dronecz/maker_badge/HW/rev_C/gerber-bom-pnp/MF_badge_2021_rev_C_BOM.xls

Designator | Qty | Value | Device | Package | LCSC part no
CR2032 | 1 |  | BATTERYCR2032_BAT-HLD-001 | CR2032_SMT_BAT-HLD-001 | C964831
R3 | 1 | 0 | R-EU_R0805 | R0805 | C17477
R2 | 1 | 0.47 | R-EU_R0805 | R0805 | C25040
R5 | 1 | 100k | R-EU_R0805 | R0805 | C149504
C8, C18 | 2 | 100n | C-EUC0805 | C0805 | C1711
R1, R7, R8, R10, R11, R12, R30, R31 | 8 | 10k | R-EU_R0805 | R0805 | C17414
C13, C14, C16, C19, C20 | 5 | 10u | C-EUC0805 | C0805 | C1713
R9 | 1 | 1M | R-EU_R0805 | R0805 | C17514
R6 | 1 | 1k | R-EU_R0805 | R0805 | C17513
C1, C2, C3, C4, C5, C6, C9, C11, C15, C17, C22 | 11 | 1u | C-EUC0805 | C0805 | C28323
R17, R18 | 2 | 22 | R-EU_R0805 | R0805 | C107702
R22, R23 | 2 | 4k7 | R-EU_R0805 | R0805 | C2907264
C10, C12 | 2 | 4u7 | C-EUC0805 | C0805 | C98192
R15, R16 | 2 | 5k1 | R-EU_R0805 | R0805 | C27834
L1 | 1 | 68uH | L-EUL4532P | L4532P | C394131
U2 | 1 | AP2112K-3.3 | VREG_SOT23-5 | SOT23-5 | C51118
BOOT, RST | 2 | KMR221GLFS | KMR221GLFS | KMR221GLFS | C72443
Q2, Q3 | 2 | DMG3415U-7 | MOSFET-P | SOT23-R | C96616
U1 | 1 | ESP32-S2-WROOM | ESP32-S2-WROOM | XCVR_ESP32-S2-WROOM | C967025
J1 | 1 | TYPE-C-31-M-12 | TYPE-C-31-M-12 | TYPE-C-31-M-12 | C165948
U$8 | 1 | JST_PH2 | JST_PH2 | JSTPH2 | C295747
D1, D2, D3, D5 | 4 | MBR0520LT | MBR0520LT | SOD123 | C165467
IC1 | 1 | MCP73831 | MCP73831 | SOT95P290X120-5 | C14879
C7 | 1 | OMIT | C-EUC0805 | C0805
R4 | 1 | OMIT | R-EU_R0805 | R0805
D4 | 1 | ORANGE | LED0805_NOOUTLINE | CHIPLED_0805_NOOUTLINE | C72037
Q1 | 1 | SI1308EDL-T1-GE3 | SI1308EDL-T1-GE3 | SOT-323 | C469327
LED2, LED3, LED4, LED5 | 4 | WS2812B5050 | WS2812B5050 | WS2812B | C2843785
