dronecz/maker_badge/HW/rev_D/MF_badge_2021_rev_D.brd

## EAGLE design HW/rev_D/MF_badge_2021_rev_D.brd (2023-02-20)

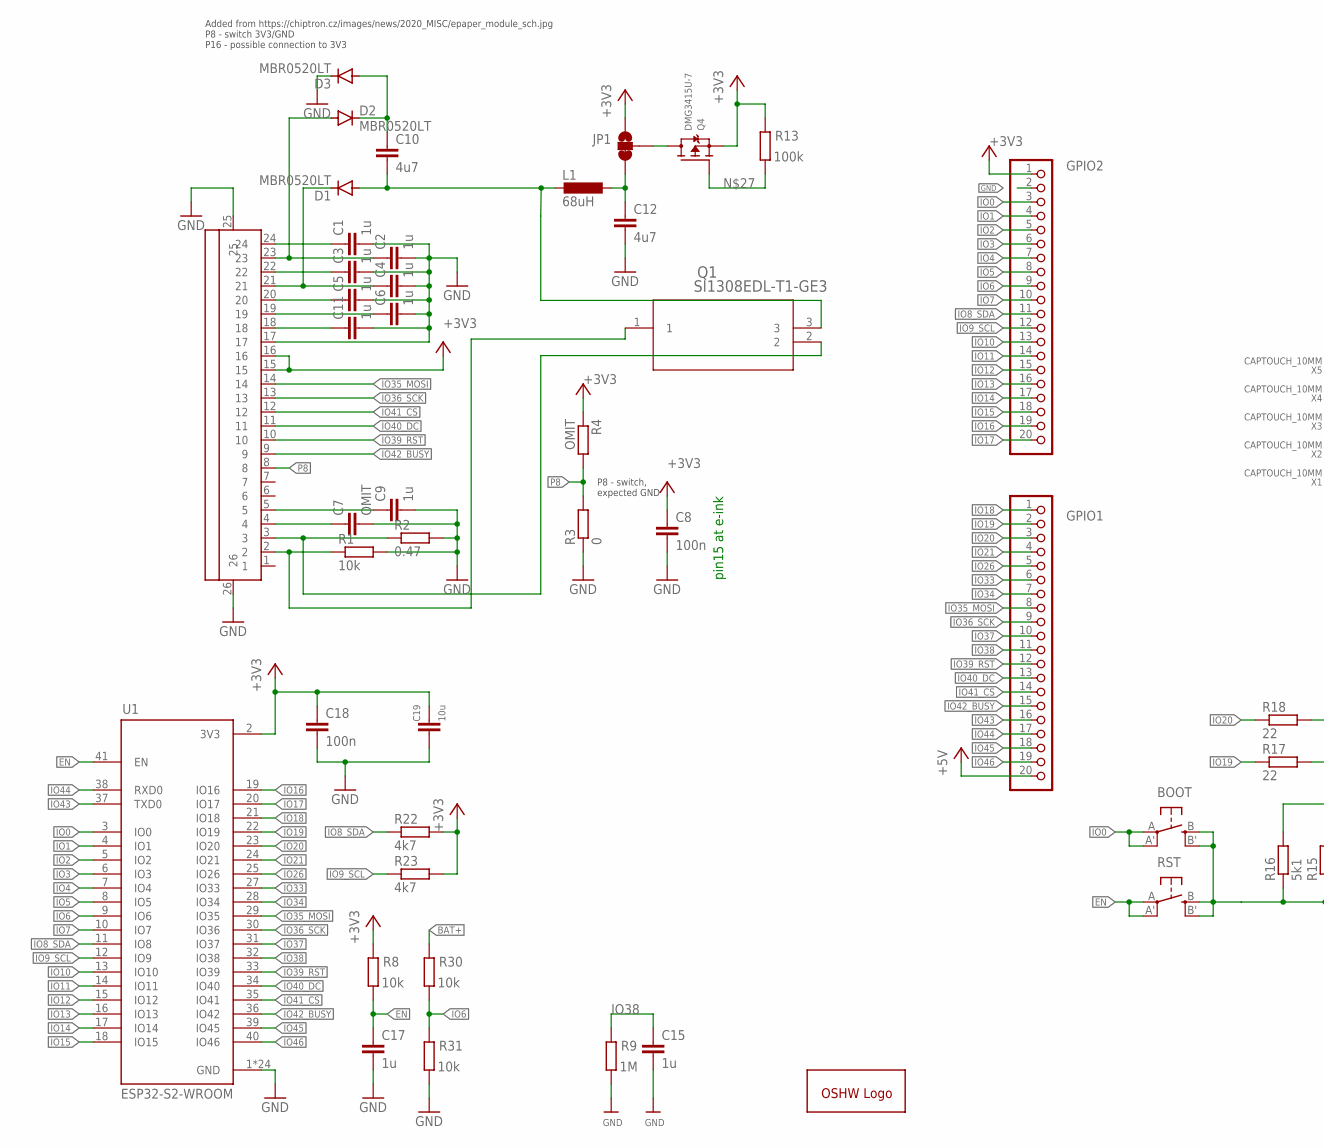
[picture p1: schematic MF_badge_2021_rev_D.sch, part in row 1, column 1]

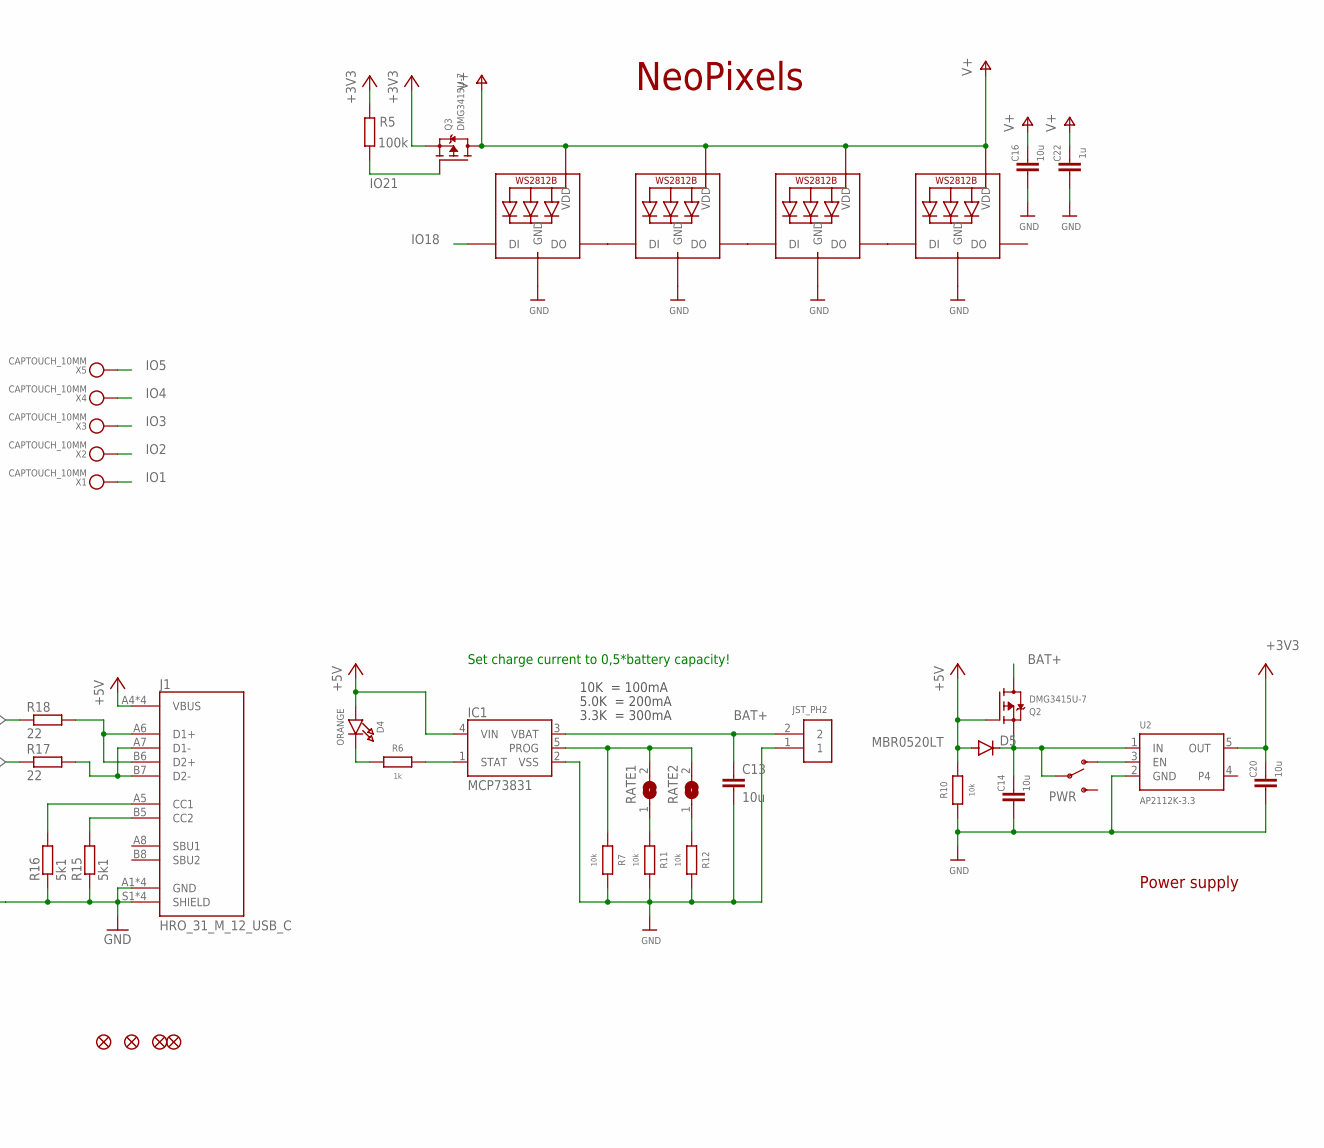
[picture p2: schematic MF_badge_2021_rev_D.sch, part in row 1, column 2]

Parts:
BOOT: BUTTON_KMR2_4.6X2.8
C1, C2, C3, C4, C5, C6, C9, C11, C15, C17, C22: 1u; C0805
C7: OMIT; C0805
C8, C18: 100n; C0805
C10, C12: 4u7; C0805
C13, C14, C16, C19, C20: 10u; C0805
D1, D2, D3, D5: MBR0520LT; SOD123
D4: ORANGE; CHIPLED_0805_NOOUTLINE
FID1, FID2, FID3, FID4: FIDUCIAL_1MM
GOLD_ORB_SM1: OSHWLOGO_; OSHW_5MM_LOGO
GPIO1, GPIO2: PINHD-1X20; 1X20
IC1: MCP73831; SOT95P290X120-5
J1: HRO_31_M_12_USB_C
JP1: JUMPER-SMT_3_1-NC_TRACE_NO-SILK; SMT-JUMPER_3_1-NC_TRACE_NO-SILK
L1: 68uH; L4532P
LED2, LED3, LED4, LED5: WS2812B5050; WS2812B
PWR: SWITCH-SPDT-SMD-RIGHT-ANGLE; SWITCH_SPST_SMD_A
Q1: SI1308EDL-T1-GE3; MOSFET_8EDL-T1-GE3_VIS
Q2, Q3, Q4: DMG3415U-7; SOT23-R
R1, R7, R8, R10, R11, R12, R30, R31: 10k; R0805
R2: 0.47; R0805
R3: 0; R0805
R4: OMIT; R0805
R5, R13: 100k; R0805
R6: 1k; R0805
R9: 1M; R0805
R15, R16: 5k1; R0805
R17, R18: 22; R0805
R22, R23: 4k7; R0805
RATE1, RATE2: SOLDERJUMPER; SOLDERJUMPER_ARROW_NOPASTE
RST: BUTTON_KMR2_4.6X2.8
U1: ESP32-S2-WROOM; XCVR_ESP32-S2-WROOM
U2: AP2112K-3.3; SOT23-5
U$1: 2.13_EINK
U$8: JST_PH2; JSTPH2
X1, X2, X3, X4, X5: CAPTOUCH_10MM; CAPTOUCH_6X9MM

Connections:
+3V3: C8.1, C18.1, C19.1, C20.1, GPIO2.1, JP1.1, Q3.2 (S), Q4.2 (S), R4.1, R5.2, R8.2, R13.2, R22.2, R23.2, U1.2 (3V3), U2.5 (OUT), U$1.15, U$1.16
+5V: D4.A, D5.A, GPIO1.20, IC1.4 (VIN), J1.A4 (VBUS), J1.A9 (VBUS), J1.B4 (VBUS), J1.B9 (VBUS), Q2.1 (G), R10.2
BAT+: C13.1, IC1.3 (VBAT), Q2.3 (D), R30.2, U$8.2
D+_CON: J1.A6 (D1+), J1.B6 (D2+), R18.2
D-_CON: J1.A7 (D1-), J1.B7 (D2-), R17.2
EN: C17.1, R8.1, RST.A, RST.A' (P1), U1.41 (EN)
GND: BOOT.B (S), BOOT.B' (S1), C1.2, C2.2, C3.2, C4.2, C5.2, C6.2, C7.2, C8.2, C9.2, C11.2, C12.2, C13.2, C14.2, C15.2, C16.2, C17.2, C18.2, C19.2, C20.2, C22.2, D3.C, GPIO2.2, IC1.2 (VSS), J1.A1 (GND), J1.A12 (GND), J1.B1 (GND), J1.B12 (GND), J1.S1 (SHIELD), J1.S2 (SHIELD), J1.S3 (SHIELD), J1.S4 (SHIELD), LED2.3-GND (GND), LED3.3-GND (GND), LED4.3-GND (GND), LED5.3-GND (GND), R1.2, R2.2, R3.1, R7.2, R9.1, R10.1, R11.2, R12.2, R15.1, R16.1, R31.1, RST.B (S), RST.B' (S1), U1.1 (GND), U1.26 (GND), U1.42 (GND), U1.43.1 (GND), U1.43.2 (GND), U1.43.3 (GND), U1.43.4 (GND), U1.43.5 (GND), U1.43.6 (GND), U1.43.7 (GND), U1.43.8 (GND), U1.43.9 (GND), U1.43.10 (GND), U1.43.11 (GND), U1.43.12 (GND), U1.43.13 (GND), U1.43.14 (GND), U1.43.15 (GND), U1.43.16 (GND), U1.43.17 (GND), U1.43.18 (GND), U1.43.19 (GND), U1.43.20 (GND), U1.43.21 (GND), U2.2 (GND), U$1.17, U$1.25, U$1.26, U$8.1
IO0: BOOT.A, BOOT.A' (P1), GPIO2.3, U1.3 (IO0)
IO1: GPIO2.4, U1.4 (IO1), X1.P$1
IO2: GPIO2.5, U1.5 (IO2), X2.P$1
IO3: GPIO2.6, U1.6 (IO3), X3.P$1
IO4: GPIO2.7, U1.7 (IO4), X4.P$1
IO5: GPIO2.8, U1.8 (IO5), X5.P$1
IO6: GPIO2.9, R30.1, R31.2, U1.9 (IO6)
IO7: GPIO2.10, U1.10 (IO7)
IO8_SDA: GPIO2.11, R22.1, U1.11 (IO8)
IO9_SCL: GPIO2.12, R23.1, U1.12 (IO9)
IO10: GPIO2.13, U1.13 (IO10)
IO11: GPIO2.14, U1.14 (IO11)
IO12: GPIO2.15, U1.15 (IO12)
IO13: GPIO2.16, U1.16 (IO13)
IO14: GPIO2.17, U1.17 (IO14)
IO15: GPIO2.18, U1.18 (IO15)
IO16: GPIO2.19, U1.19 (IO16)
IO17: GPIO2.20, U1.20 (IO17)
IO18: GPIO1.1, LED2.4-DIN (DI), U1.21 (IO18)
IO19: GPIO1.2, R17.1, U1.22 (IO19)
IO20: GPIO1.3, R18.1, U1.23 (IO20)
IO21: GPIO1.4, Q3.1 (G), R5.1, U1.24 (IO21)
IO26: GPIO1.5, U1.25 (IO26)
IO33: GPIO1.6, U1.27 (IO33)
IO34: GPIO1.7, U1.28 (IO34)
IO35_MOSI: GPIO1.8, U1.29 (IO35), U$1.14
IO36_SCK: GPIO1.9, U1.30 (IO36), U$1.13
IO37: GPIO1.10, U1.31 (IO37)
IO38: C15.1, GPIO1.11, R9.2, U1.32 (IO38)
IO39_RST: GPIO1.12, U1.33 (IO39), U$1.10
IO40_DC: GPIO1.13, U1.34 (IO40), U$1.11
IO41_CS: GPIO1.14, U1.35 (IO41), U$1.12
IO42_BUSY: GPIO1.15, U1.36 (IO42), U$1.9
IO43: GPIO1.16, U1.37 (TXD0)
IO44: GPIO1.17, U1.38 (RXD0)
IO45: GPIO1.18, U1.39 (IO45)
IO46: GPIO1.19, U1.40 (IO46)
unnamed: C1.1, U$1.24
unnamed: C2.1, D2.A, U$1.23
unnamed: C3.1, U$1.22
unnamed: C4.1, D1.C, U$1.21
unnamed: C5.1, U$1.20
unnamed: C6.1, U$1.19
unnamed: C11.1, U$1.18
unnamed: IC1.1 (STAT), R6.2
unnamed: C14.1, D5.C, PWR.2, Q2.2 (S), U2.1 (IN)
unnamed: Q1.2, R2.1, U$1.3
unnamed: C9.1, U$1.5
unnamed: C7.1, U$1.4
unnamed: Q1.1, R1.1, U$1.2
unnamed: D4.C, R6.1
unnamed: C10.1, D2.C, D3.A
unnamed: LED2.2-DOUT (DO), LED3.4-DIN (DI)
unnamed: PWR.1 (O), U2.3 (EN)
unnamed: C10.2, D1.A, L1.2, Q1.3
unnamed: R11.1, RATE1.1
unnamed: R12.1, RATE2.1
unnamed: LED4.2-DOUT (DO), LED5.4-DIN (DI)
unnamed: J1.B5 (CC2), R15.2
unnamed: J1.A5 (CC1), R16.2
unnamed: LED3.2-DOUT (DO), LED4.4-DIN (DI)
unnamed: C12.1, JP1.3, L1.1
unnamed: Q4.1 (G), R13.1
unnamed: JP1.2, Q4.3 (D)
P8: R3.2, R4.2, U$1.8
PROG: IC1.5 (PROG), R7.1, RATE1.2, RATE2.2
V+: C16.1, C22.1, LED2.1-VDD (VDD), LED3.1-VDD (VDD), LED4.1-VDD (VDD), LED5.1-VDD (VDD), Q3.3 (D)

Notes on the sheet:
P8 - switch, expected GND
Added from https://chiptron.cz/images/news/2020_MISC/epaper_module_sch.jpg P8 - switch 3V3/GND P16 - possible connection to 3V3
10K = 100mA
5.0K = 200mA
3.3K = 300mA
Set charge current to 0,5*battery capacity!
Power supply
pin15 at e-ink
NeoPixels

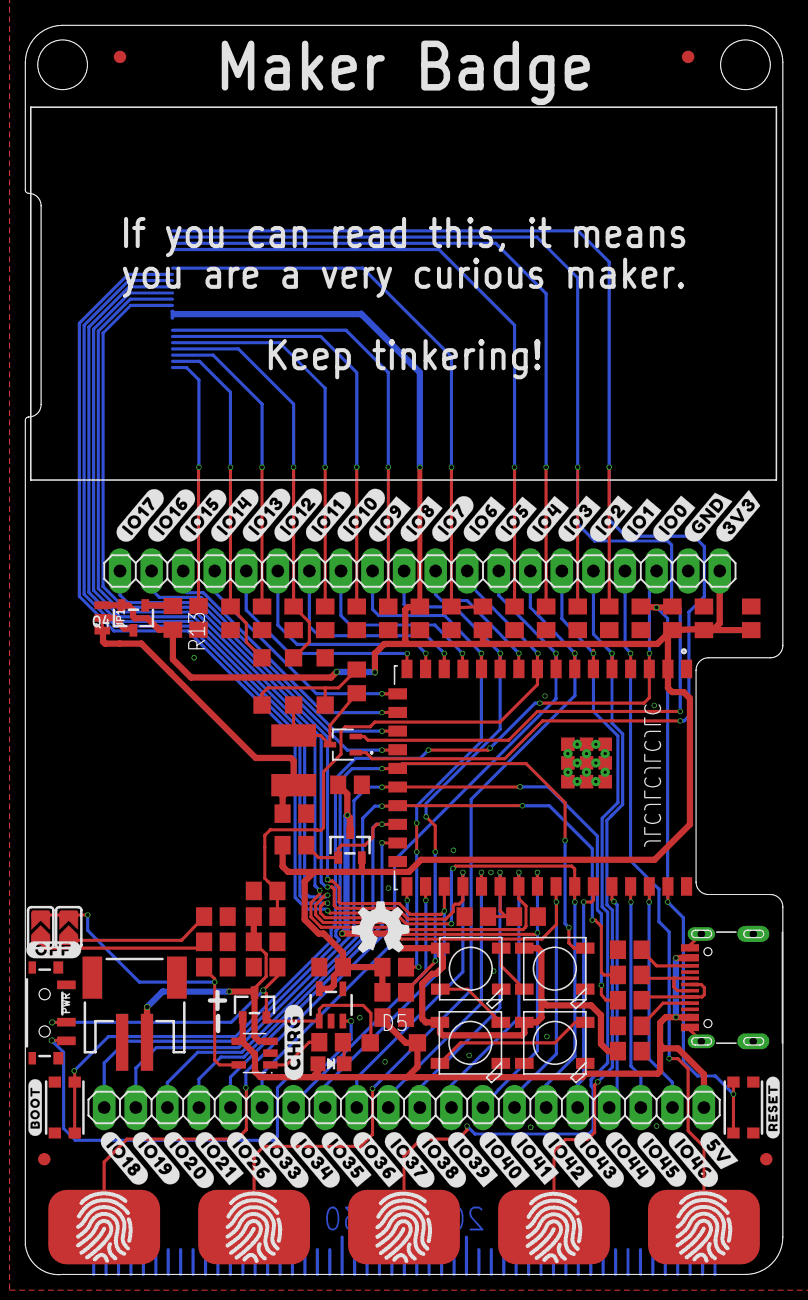
[picture p3: board MF_badge_2021_rev_D.brd from above]

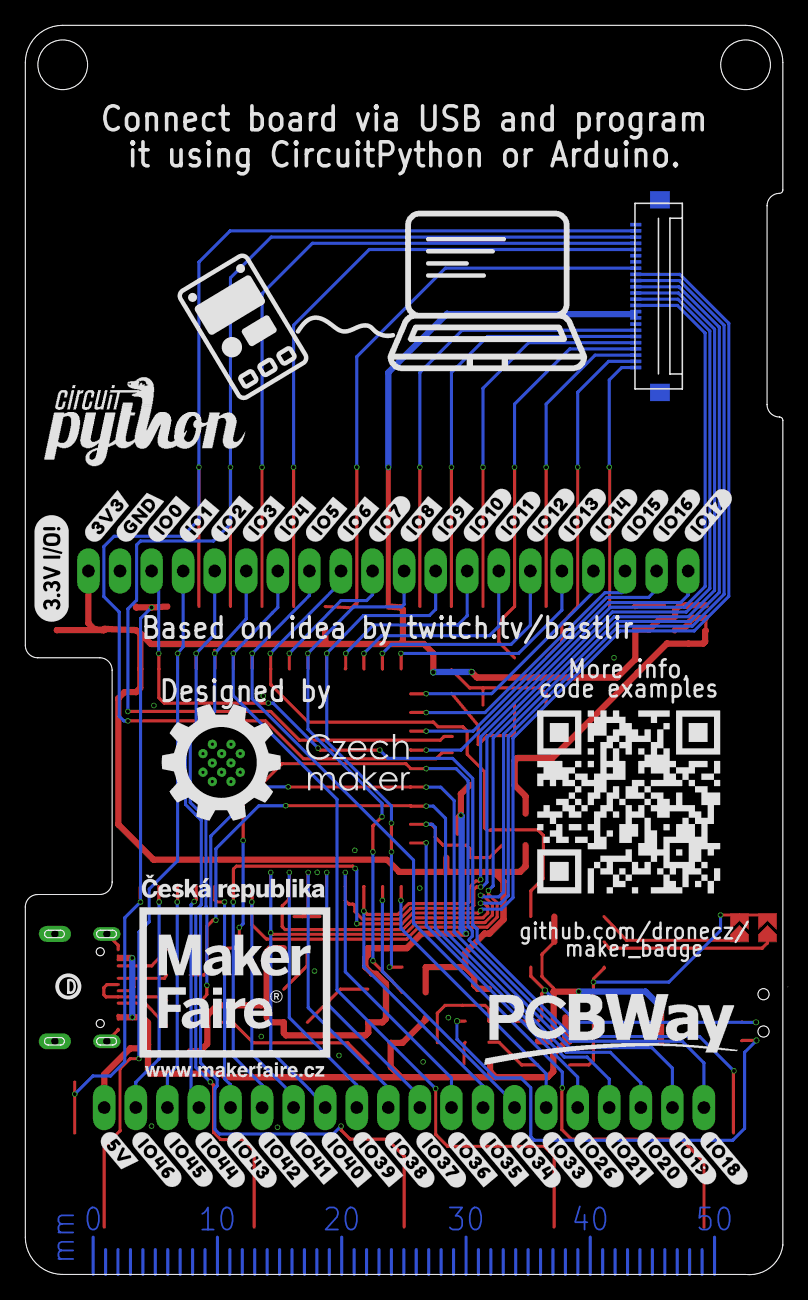
[picture p4: board MF_badge_2021_rev_D.brd from below]

Board: 2 copper layers, 61.0 x 100.5 mm, 165 parts (41 on the bottom side), 74 nets.

Other parts of the board:
U$2, U$92: #IO43#0
U$3, U$93: #IO44#0
U$4, U$33: #IO17#0
U$6, U$34: #IO16#0
U$7: #BOOT#0
U$9: #RESET#0
U$10: PCBFEAT-REV-040
U$12: #CHRG#0
U$16, U$77: #IO18#0
U$17, U$78: #IO19#0
U$18, U$79: #IO20#0
U$19, U$80: #IO21#0
U$20, U$81: #IO26#0
U$21, U$82: #IO33#0
U$22, U$83: #IO34#0
U$23, U$84: #IO35#0
U$24, U$85: #IO36#0
U$25, U$87: #IO38#0
U$26, U$86: #IO37#0
U$27, U$88: #IO39#0
U$28, U$89: #IO40#0
U$29, U$90: #IO41#0
U$30, U$91: #IO42#0
U$31, U$94: #IO45#0
U$32, U$95: #IO46#0
U$35, U$57: #IO15#0
U$37, U$58: #IO14#0
U$38, U$59: #IO13#0
U$39, U$60: #IO12#0
U$40, U$65: #IO11#0
U$41, U$66: #IO10#0
U$42, U$67: #IO9#0
U$43, U$68: #IO8#0
U$44, U$69: #IO7#0
U$45, U$70: #IO6#0
U$46, U$71: #IO5#0
U$47, U$72: #IO4#0
U$48, U$73: #IO3#0
U$49, U$74: #IO2#0
U$50, U$75: #IO1#0
U$51, U$76: #IO0#0
U$56: #OFF#0
U$96, U$100: #GND#0
U$97, U$101: #3V3#0
U$98, U$99: #5V#0
