dronecz/maker_badge/(commit log)

2021-11-21 Initial commit of files
    [MF_badge_2021_rev_A.brd, MF_badge_2021_rev_A.sch]
2022-08-18 Update to latest HW version
    [MF_badge_2021_rev_B.brd, MF_badge_2021_rev_B.sch]
2022-11-20 Update
    - changed filename for Arduino example code
    - add combined.bin for CPY
    - add example code from MF for CPY
2022-12-04 Added basic text example for Arduino
2023-02-20 Add rev.C files
    [MF_badge_2021_rev_C.brd, MF_badge_2021_rev_C.sch, MF_badge_2021_rev_C_BOM.xls, MF_badge_2021_rev_C_PP.csv]
2023-02-20 Add rev_D -> work in progress
    [MF_badge_2021_rev_D.brd, MF_badge_2021_rev_D.sch]
