dronecz/maker_badge/(notices)

Notices in the files:
parts and their libraries:
microbuilder: This work is placed in the public domain, and may be freely used for commercial and non-commercial work with the following conditions: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
SI1308EDL-T1-GE3: COPYRIGHT: Copyright (C) 2022 Ultra Librarian. All rights reserved.
